Aurora-Electronic-BMS/BMS_Master_Hardware/production/bom.csv

Designator | Footprint | Quantity | Value | LCSC Part #
C1, C10, C11, C16, C17, C18, C2, C20, C21, C22, C24, C25, C26, C28, C29, C3, C30, C31, C32, C33, C34, C35, C36, C37, C38, C4, C43, C47, C50, C51 | 0603 | 30 | 100n
C12, C9 | 0603 | 2 | 1u
C13 | 0603 | 1 | 4u7
C14, C15, C27, C44, C45 | 0603 | 5 | 10u
C19, C23, C52 | 0603 | 3 | 1uF
C39, C40 | 0603 | 2 | 2.2uF
C41, C42, C48 | 0603 | 3 | 22pF
C46, C49 | 0603 | 2 | 22u
C5, C6, C7, C8 | 0603 | 4 | 100pF
C53 | 0603 | 1 | 2.2u
D1, D14, D15, D16, D17, D19 | 0603 | 6 | BLUE
D10, D11, D12, D13 | 0603 | 4 | GREEN
D18 | 0603 | 1 | WHITE
D2 | D_SOD-123 | 1 | 1N4148W
D20, D21 | SOT-23 | 2 | PESD2CAN,215
D22 | D_SOD-123 | 1 | BZT52C15
D23 | D_SMA | 1 | SS34
D25 | D_SOD-123 | 1 | SMF6.0CA
D3 | D_SOD-123F | 1 | SMF36CA
D4, D6, D7, D8 | 0603 | 4 | YELLOW
D5, D9 | 0603 | 2 | RED
F1, F3 | 0603 | 2 | 1A
F2 | 0603 | 1 | 2A
FB1, FB2, FB3, FB4, FB5 | 0603 | 5 | 60R@100MHz
H1, H2, H3, H4 | MountingHole_2.7mm_M2.5_ISO14580_Pad | 4 | Mounting_Pad
J1, J2 | boot | 2 | SolderJumper-predefined
J10, J3, J4, J7, J8, J9 | Molex_Micro-Fit_3.0_43650-0215_1x02_P3.00mm_Vertical | 6 | Conn_01x02
J11, J13 | Molex_Micro-Fit_3.0_43650-0415_1x04_P3.00mm_Vertical | 2 | Conn_01x04
J14, J6 | Molex_Micro-Fit_3.0_43650-0315_1x03_P3.00mm_Vertical | 2 | Conn_01x03
J16 | PinHeader_1x04_P1.27mm_Vertical | 1 | Conn_01x04
J17 | JST_GH_BM04B-GHS-TBT_1x04-1MP_P1.25mm_Vertical | 1 | Conn_01x04
J20, J21 | PinHeader_1x05_P1.27mm_Vertical | 2 | Conn_01x05
J5 | USB_C_Receptacle_HCTL_HC-TYPE-C-16P-01A | 1 | USB_C_Receptacle_USB2.0_16P
L1 | 0603 | 1 | 600R@100MHz
L2 | L_Changjiang_FXL0530 | 1 | 4u7
Q1 | SOT-23 | 1 | DMN61D8LQ
Q2 | SOT-23 | 1 | 2N7002K
R1, R2, R3, R4, R49, R5, R6 | 0603 | 7 | 10k
R10, R17, R46, R7, R8, R9 | 0603 | 6 | 1k
R11, R12 | 0603 | 2 | 120
R13, R14 | 0603 | 2 | 5k1
R15, R16, R23, R24, R25, R26, R27, R28, R29, R30, R31, R32, R33, R34, R35, R36, R37, R38 | 0603 | 18 | 3k3
R18 | 0603 | 1 | 47
R19, R59, R61 | 0603 | 3 | 2k2
R39, R40, R52, R58, R60, R62 | 0603 | 6 | 4k7
R41, R42, R43, R44 | 0603 | 4 | 60
R45, R53, R54, R55, R57, R64 | 0603 | 6 | 100k
R47 | 0603 | 1 | 0
R48 | 0603 | 1 | 220
R50 | 0603 | 1 | 15k
R51 | 0603 | 1 | 470
R56 | 0603 | 1 | 2k
R63 | 0603 | 1 | 79k
SW1 | SW_DIP_SPSTx01_Slide_6.7x4.1mm_W6.73mm_P2.54mm_LowProfile_JPin | 1 | RESET
T1, T2 | HM2103NL_PUL | 2 | HM2103NL
T3 | EE10 | 1 | ~
U1, U2 | MS_05-08-1669_ADI | 2 | LTC6820HMS-TRPBF
U10 | SOIC-8_3.9x4.9mm_P1.27mm | 1 | AT24C521C
U11, U12 | SOIC-8_7.5x5.85mm_P1.27mm | 2 | ISO1042
U13 | LQFP-100_14x14mm_P0.5mm | 1 | STM32F407VGT6
U14, U15, U16, U6 | SMD-4_L4.5-W2.7-P1.27-LS4.9-TL | 4 | PS7802
U17 | SOT-23-6 | 1 | PW2312
U18 | TSOT-23-5 | 1 | JW3510
U3 | SOT-23-6 | 1 | USBLC6-2SC6
U4 | WCH_QFN-16-1EP_3x3mm_P0.5mm_EP1.8x1.8mm | 1 | CH343P
U5 | SOT-583-8 | 1 | TPS2116DRL
U7 | TO-252-2 | 1 | LF33CDT-TR
U8 | SOIC-16W_7.5x10.3mm_P1.27mm | 1 | ISO7730FDWR
U9 | SOP-8_3.9x4.9mm_P1.27mm | 1 | NSD12409-Q1
X1 | Crystal_SMD_Abracon_ABM8AIG-4Pin_3.2x2.5mm | 1 | X3225 16MOB4SI
