Aurora-Electronic-BMS/BMS_Master_Hardware/BMS_Master.csv

Reference | Qty | Value | DNP | Exclude from BOM | Exclude from Board | Footprint | Datasheet
C1 | 1 | 4u7 |  |  |  | Capacitor_SMD:C_0603_1608Metric | ~
C2,C3,C4,C6,C9,C10,C11,C13,C14,C15,C19,C22,C24,C29,C31,C32,C33,C34,C35,C36,C39,C42,C43,C44 | 24 | 100n |  |  |  | Capacitor_SMD:C_0603_1608Metric | ~
C5,C12 | 2 | 1uF |  |  |  | Capacitor_SMD:C_0603_1608Metric | ~
C7,C8 | 2 | 22pF |  |  |  | Capacitor_SMD:C_0603_1608Metric | ~
C16,C17,C30 | 3 | 2.2u |  |  |  | Capacitor_SMD:C_0603_1608Metric | ~
C18,C23 | 2 | 1u |  |  |  | Capacitor_SMD:C_0603_1608Metric | ~
C20,C21 | 2 | 2.2uF |  |  |  | Capacitor_SMD:C_0603_1608Metric | ~
C25 | 1 | 6.8nF |  |  |  | Capacitor_SMD:C_0603_1608Metric | ~
C26,C27,C28 | 3 | 39pF |  |  |  | Capacitor_SMD:C_0603_1608Metric | ~
C37,C38,C40,C41 | 4 | 100pF |  |  |  | Capacitor_SMD:C_0603_1608Metric | ~
D1,D3,D11,D12,D19 | 5 | RED |  |  |  | Diode_SMD:D_0603_1608Metric | ~
D2 | 1 | B560C-13-F |  |  |  | Diode_SMD:D_SMB | ~
D4,D7,D10 | 3 | GREEN |  |  |  | Diode_SMD:D_0603_1608Metric | ~
D5,D14 | 2 | PESD2CAN,215 |  |  |  | Package_TO_SOT_SMD:SOT-23
D6,D8,D9,D13,D15,D16,D17,D18 | 8 | YELLOW |  |  |  | Diode_SMD:D_0603_1608Metric | ~
F1,F4 | 2 | 1A |  |  |  | Fuse:Fuse_0603_1608Metric | ~
F2 | 1 | 2A |  |  |  | Fuse:Fuse_0603_1608Metric | ~
F3 | 1 | 4A |  |  |  | Fuse:Fuse_0603_1608Metric | ~
FB1,FB2,FB3 | 3 | 60R@100MHz |  |  |  | Inductor_SMD:L_0603_1608Metric | ~
H1,H2,H3,H4 | 4 | Mounting_Pad |  |  |  | MountingHole:MountingHole_2.7mm_M2.5_ISO14580_Pad | ~
J1 | 1 | Conn_02x03_Counter_Clockwise |  |  |  | Connector_PinHeader_2.54mm:PinHeader_2x03_P2.54mm_Vertical | ~
J2 | 1 | Conn_01x04 |  |  |  | Connector_JST:JST_GH_BM04B-GHS-TBT_1x04-1MP_P1.25mm_Vertical | ~
J4,J5,J6,J7,J9 | 5 | Conn_01x02 |  |  |  | Connector_Molex:Molex_Micro-Fit_3.0_43650-0215_1x02_P3.00mm_Vertical | ~
J8,J18,J20 | 3 | Conn_01x03 |  |  |  | Connector_Molex:Molex_Micro-Fit_3.0_43650-0315_1x03_P3.00mm_Vertical | ~
J10,J11 | 2 | Conn_01x04 |  |  |  | Connector_PinHeader_2.54mm:PinHeader_1x04_P2.54mm_Vertical | ~
J12 | 1 | Conn_01x04 |  |  |  | Connector_Molex:Molex_Micro-Fit_3.0_43650-0415_1x04_P3.00mm_Vertical | ~
J16,J17 | 2 | 436500213 |  |  |  | footprints:CONN_SD-43650-005_02_MOL | 436500213
L1 | 1 | 600R@100MHz |  |  |  | Capacitor_SMD:C_0603_1608Metric | ~
L2 | 1 | 8.2uH |  |  |  | Inductor_SMD:L_1008_2520Metric_Pad1.43x2.20mm_HandSolder | ~
P1 | 1 | USB_C_Plug_USB2.0 |  |  |  | Connector_USB:USB_C_Receptacle_GCT_USB4105-xx-A_16P_TopMnt_Horizontal | https://www.usb.org/sites/default/files/documents/usb_type-c.zip
R1,R7 | 2 | 100k |  |  |  | Resistor_SMD:R_0603_1608Metric | ~
R2,R24,R25,R26,R29 | 5 | 1k |  |  |  | Resistor_SMD:R_0603_1608Metric | ~
R3 | 1 | 47 |  |  |  | Capacitor_SMD:C_0603_1608Metric | ~
R4,R16,R17,R18,R19,R20,R21,R51,R52,R53 | 10 | 10k |  |  |  | Resistor_SMD:R_0603_1608Metric | ~
R5 | 1 | 0 |  |  |  | Capacitor_SMD:C_0603_1608Metric | ~
R6 | 1 | 220 |  |  |  | Capacitor_SMD:C_0603_1608Metric | ~
R8 | 1 | 162k |  |  |  | Resistor_SMD:R_0603_1608Metric | ~
R9 | 1 | 523k |  |  |  | Resistor_SMD:R_0603_1608Metric | ~
R10 | 1 | 84.5k |  |  |  | Resistor_SMD:R_0603_1608Metric | ~
R11 | 1 | 13k |  |  |  | Resistor_SMD:R_0603_1608Metric | ~
R12,R22,R23,R27,R28,R31,R33,R34,R35,R36,R37,R40,R41,R42,R43,R44,R46,R48,R50 | 19 | 3k3 |  |  |  | Resistor_SMD:R_0603_1608Metric | ~
R13 | 1 | 53.6k |  |  |  | Resistor_SMD:R_0603_1608Metric | ~
R14 | 1 | 10.2k |  |  |  | Resistor_SMD:R_0603_1608Metric | ~
R15,R38,R39,R54 | 4 | 60 |  |  |  | Resistor_SMD:R_0603_1608Metric | ~
R30,R32 | 2 | 120 |  |  |  | Resistor_SMD:R_0603_1608Metric | ~
R45,R47,R49 | 3 | 21k |  |  |  | Resistor_SMD:R_0603_1608Metric | ~
SW1 | 1 | RESET |  |  |  | Button_Switch_SMD:SW_DIP_SPSTx01_Slide_6.7x4.1mm_W6.73mm_P2.54mm_LowProfile_JPin | ~
T1,T2 | 2 | HM2103NL |  |  |  | footprints:HM2103NL_PUL | HM2103NL
U1 | 1 | USBLC6-2SC6 |  |  |  | Package_TO_SOT_SMD:SOT-23-6 | https://www.st.com/resource/en/datasheet/usblc6-2.pdf
U2 | 1 | CH343P |  |  |  | Package_DFN_QFN:WCH_QFN-16-1EP_3x3mm_P0.5mm_EP1.8x1.8mm | https://www.wch-ic.com/downloads/CH343DS1_PDF.html
U3 | 1 | TPS54360BQDDARQ1 |  |  |  | Package_SO:TI_SO-PowerPAD-8_ThermalVias | http://www.ti.com/lit/ds/symlink/tps54360.pdf
U4 | 1 | STM32F407VGT6 |  |  |  | Package_QFP:LQFP-100_14x14mm_P0.5mm | https://www.st.com/resource/en/datasheet/stm32f407vg.pdf
U5 | 1 | A2550KLPTR-T |  |  |  | Package_SO:TSSOP-16-1EP_4.4x5mm_P0.65mm | http://www.szlcsc.com/product/details_157725.html
U6 | 1 | LF33CDT-TR |  |  |  | Package_TO_SOT_SMD:TO-252-2 | http://www.szlcsc.com/product/details_222560.html
U7,U8 | 2 | LTC6820HMS-TRPBF |  |  |  | footprints:MS_05-08-1669_ADI | LTC6820HMS-TRPBF
U9,U10 | 2 | TCAN1057AVDRQ1 |  |  |  | Package_SO:TI_SO-PowerPAD-8_ThermalVias | http://www.ti.com/lit/ds/symlink/tcan337.pdf
X1 | 1 | X3225 16MOB4SI |  |  |  | Crystal:Crystal_SMD_Abracon_ABM8AIG-4Pin_3.2x2.5mm | http://www.szlcsc.com/product/details_383475.html
