Aurora-Electronic-BMS/BMS_Master_Hardware/BMS_Master.step

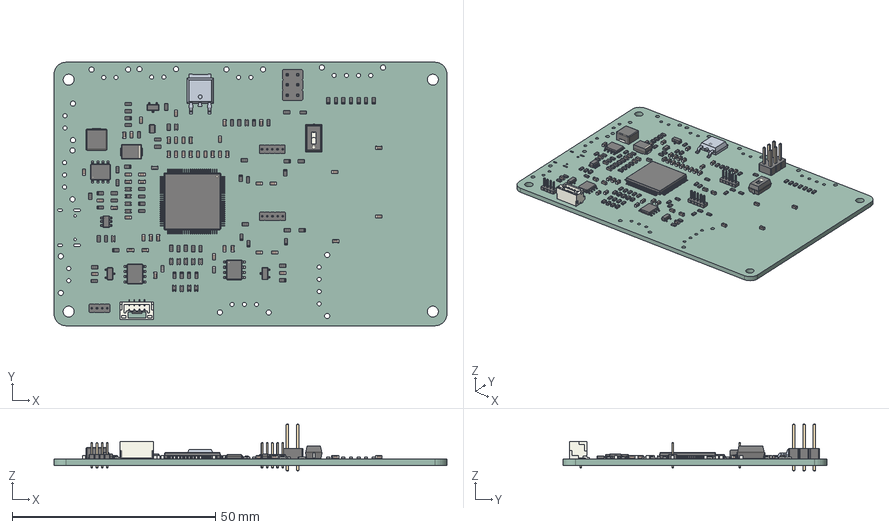
[picture p1: CAD file, 2026-09-15]
BMS_Master.step
96.6 x 64.8 x 11.5 mm
D_0603_1608Metric x 16
C_0603_1608Metric x 47
R_0603_1608Metric x 58
SOT-23-6
D_SMB
JST_GH_BM04B-GHS-TBT_1x04-1MP_P1.25mm_Vertical
SOT-583-8
HTSOP-8-1EP_3.9x4.9mm_Pitch1.27mm x 3
Fuse_0603_1608Metric x 4
L_0603_1608Metric x 3
SOT-23 x 3
BMS_Master 1.50.1
PinHeader_1x05_P1.27mm_Vertical x 2
LQFP-100_14x14mm_P0.5mm
PinHeader_2x03_P2.54mm_Vertical
L_APV_APH0530
SW_DIP_SPSTx01_Slide_6.7x4.1mm_W6.73mm_P2.54mm_LowProfile_JPin
PinHeader_1x04_P1.27mm_Vertical
BMS_Master_PCB
